GrahamWidmann/420handheldproject/Documentation/01-ConceptDevelopment-GW.pdf

Graham Widmann

Step 01

Tools, brush sizes, and hardness levels are difficult to find and tough to change mid-edit without opening other tabs and loosing concentration on the current editable area.

I plan on making a device that will attach a computer and allow the user to have quick access to certain tools that are hard to get access to without opening new windows. There will be a screen that will make it easy to get to tools like the hardness and size levels. There will also be some other tools like the brush, gradient, and pen tool. There will be a trackball as well to make it easy to zoom out readjust your seeing area.

Influences:

- Trackball mouse

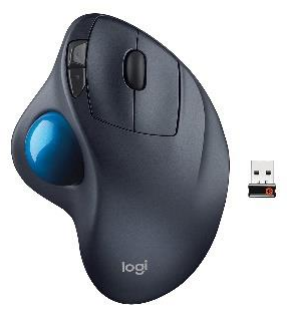
[picture p6: figure]

- I plan on modeling the attachment after a trackball mouse with a small screen near the finger tips.
- https://www.amazon.com/gp/product/B0043T7FXE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 (https://www.amazon.com/gp/product/B0043T7FXE)
- Programmable keyboard

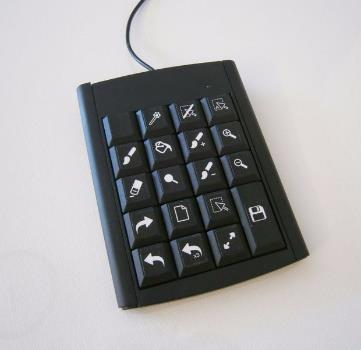
[picture p7: figure]

- Keys like this will be used for activation of different tools within photoshop. Many of them will be digital or be more ergonomically fit.
- http://www.instructables.com/id/Making-a-powerful-programmable-keypad-for-lesstha/ (http://www.instructables.com/id/Making-a-powerful-programmable-keypad-for-less-tha/)

- Corsair Scimitar PRO RGB Optical Moba/MMO Gaming Mouse

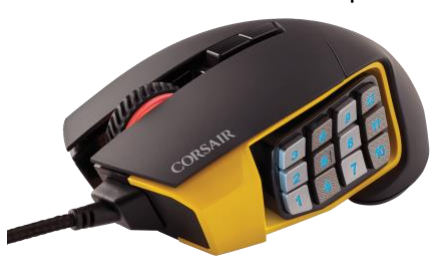
[picture p8: figure]

- I plan on using a layout like the one on this mouse so that all the buttons are easily accessible and reachable for the user. It should be as easy as possible to use.
- https://www.newegg.com/Product/Product.aspx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
N82E16826816069&gclid=EAIaIQobChMIhbaByIDb2AIVDtlkCh0MZAyXEAkYASABEgITTfD _BwE&gclsrc=aw.ds (https://www.newegg.com/Product/Product.aspx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)
