GrahamWidmann/420handheldproject/Documentation/08_Form Production.pdf

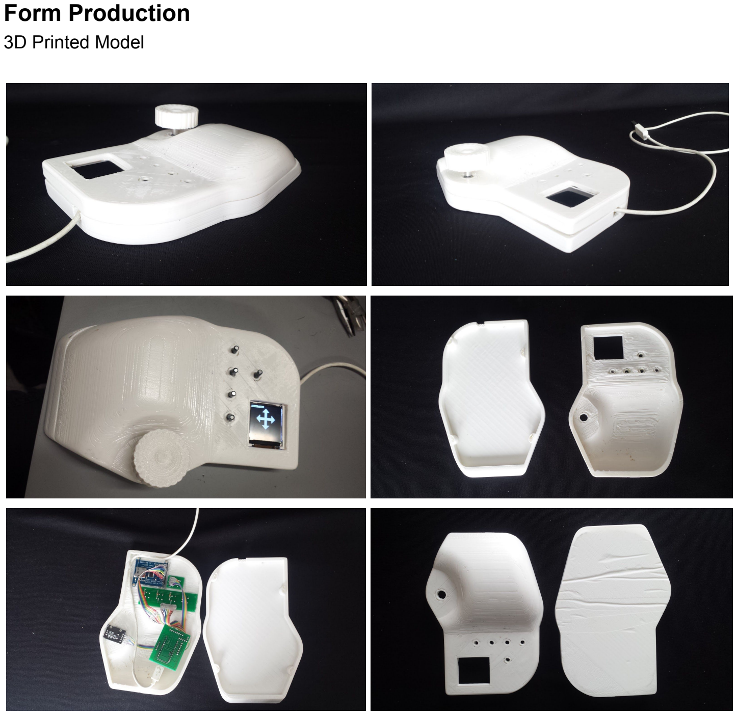
[picture p11: page 1]

### Form Production

3D Printed Model
