GrahamWidmann/420handheldproject/Documentation/07_Function Production.pdf

### Function Production

Finalized Software
The Code is in my GitHub in the code folder. It has the following libraries: Adafruit GFX Library
Adafruit

Printed PCB

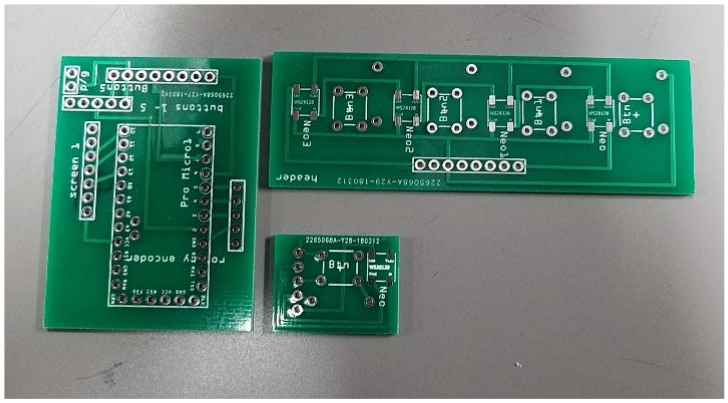
[picture p12: figure]

Combined Components

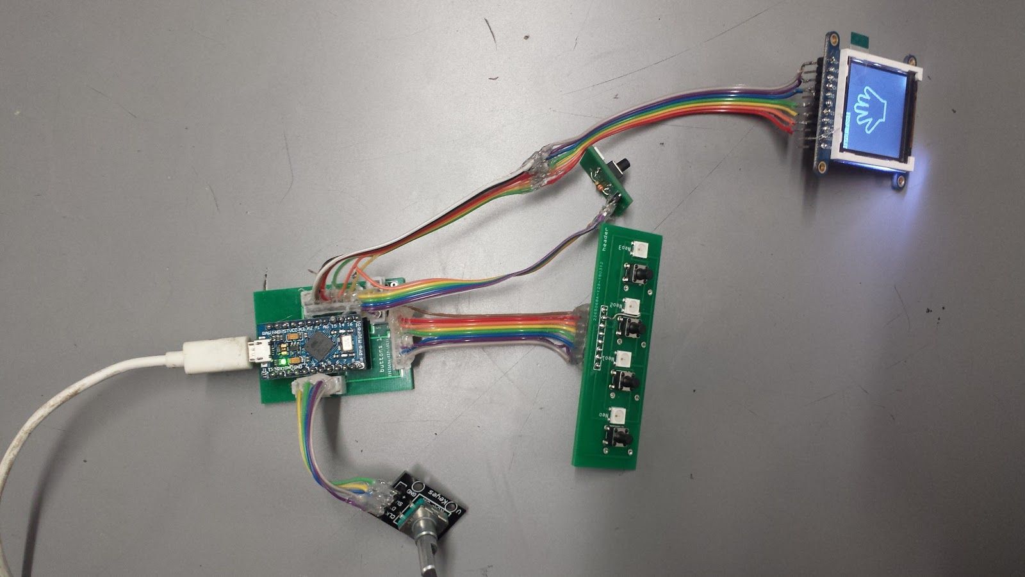
[picture p13: figure]
