GrahamWidmann/420handheldproject/Documentation/04-Function Development_GW.pdf

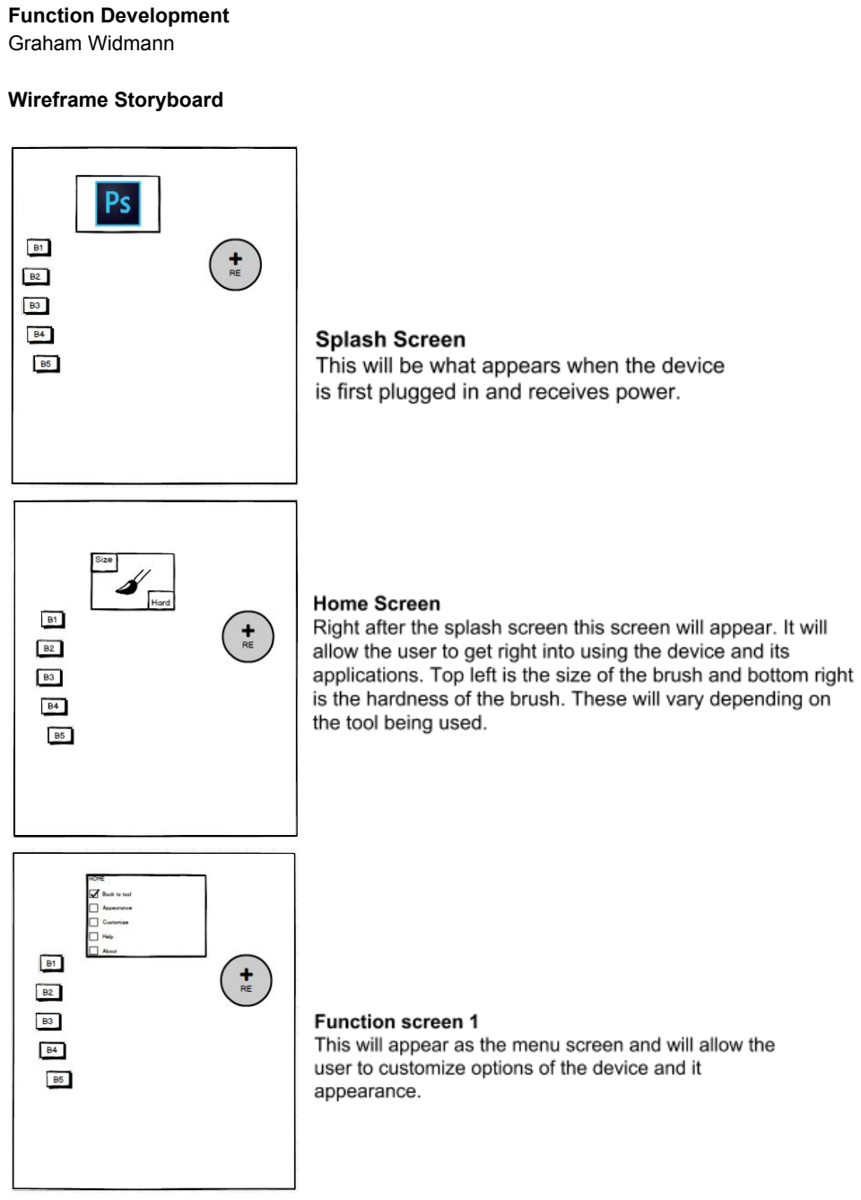
[picture p17: page 1]

Function Development
Graham Widmann

Wireframe Storyboard

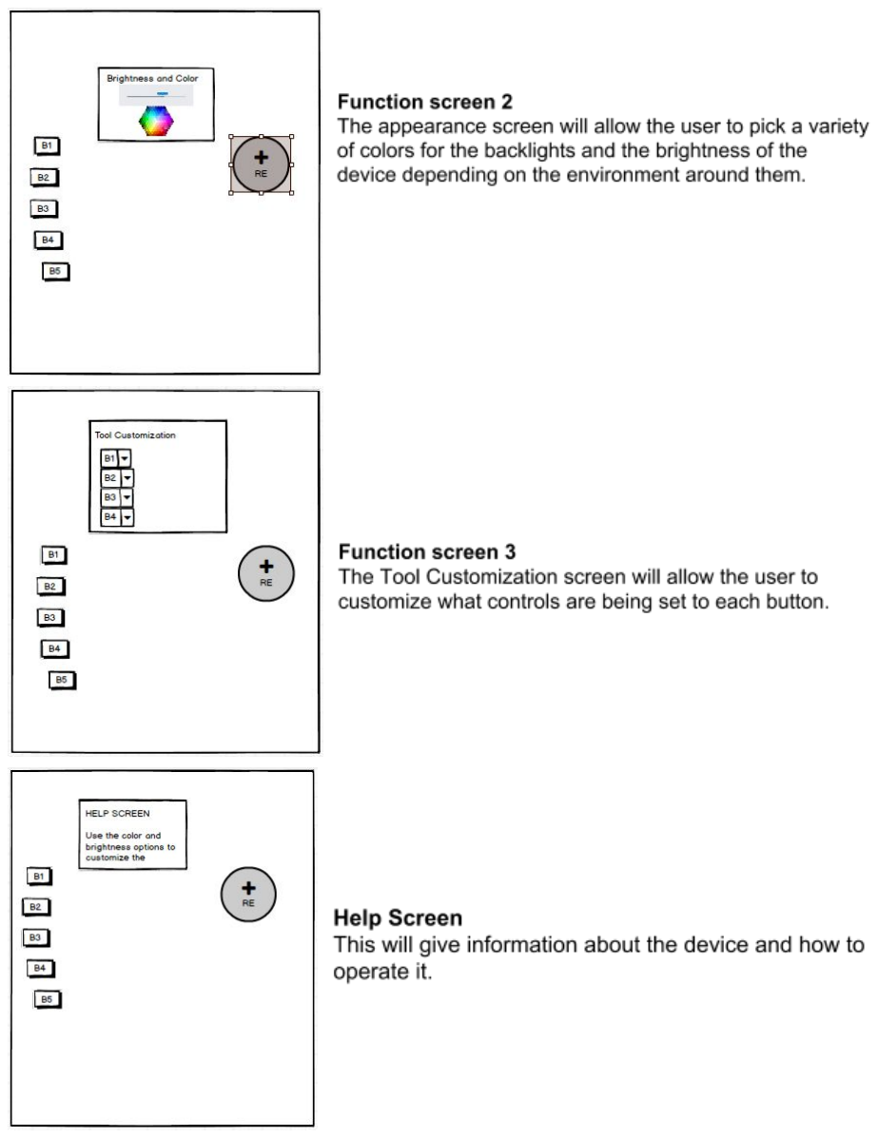
[picture p18: page 2]

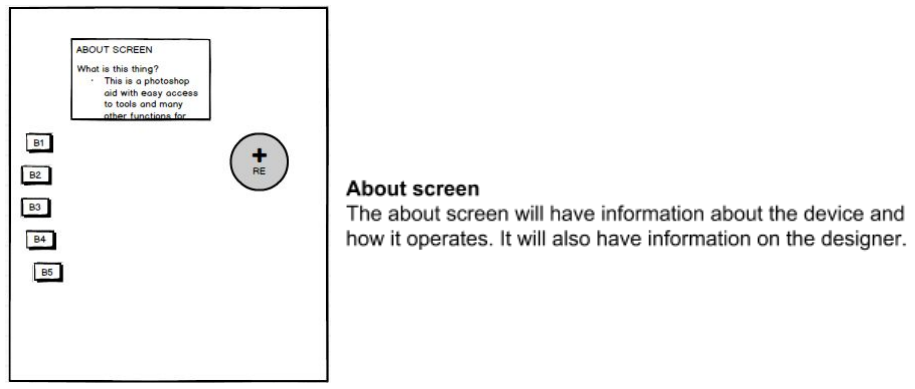
[picture p19: figure]

Component Sketch

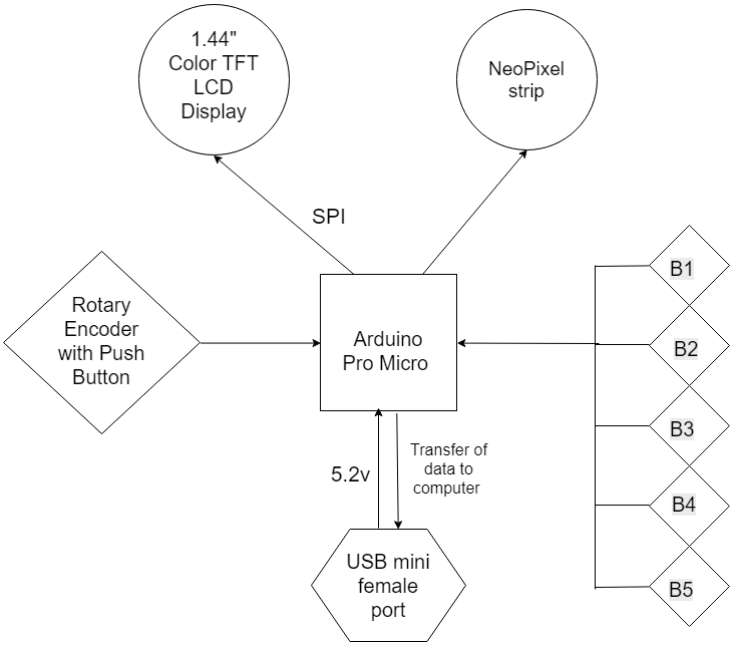
[picture p20: figure]

Bill of materials

Name | Source | URL | Qty. bought | Qty. Used | Cost ($)
Arduino Pro Micro | Amazon | https://goo.gl/iLcZLu | 1 | 1 | 7.98
Push Buttons | Amazon | https://goo.gl/GPt8HP | 140 | 5 | 9.99
Rotary Encoder | Amazon | https://goo.gl/AovCwu | 1 | 1 | 6.45
10k Resistors | Amazon | https://goo.gl/ZGPK4U | 100 | 7 | 6.43
1.44" Color TFT LCD Display with MicroSD Card breakout - ST7735R | Amazon | https://goo.gl/hdFoF1 | 1 | 1 | 18.29
Male Header pins | Amazon | https://goo.gl/6y4iy7 | 800 | 40 | 6.99
Female/ female jumper wires | Amazon | https://goo.gl/t5MnrA | 120 | 40 | 6.98

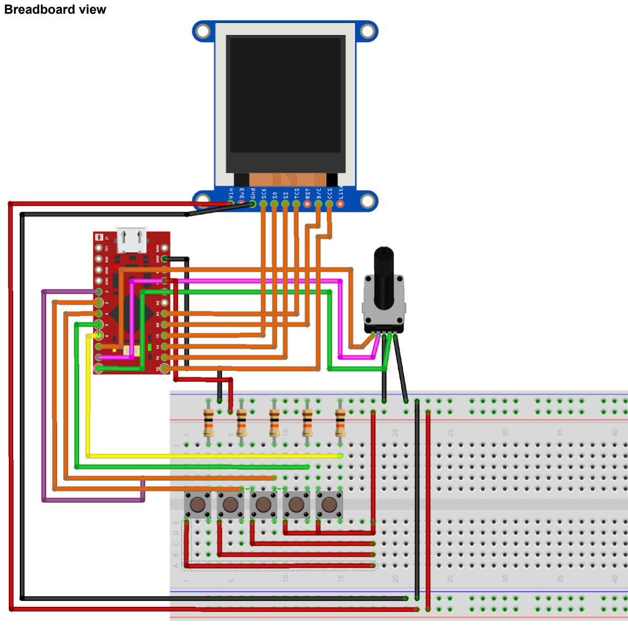
[picture p21: page 6]

Breadboard view

Electronic schematic view

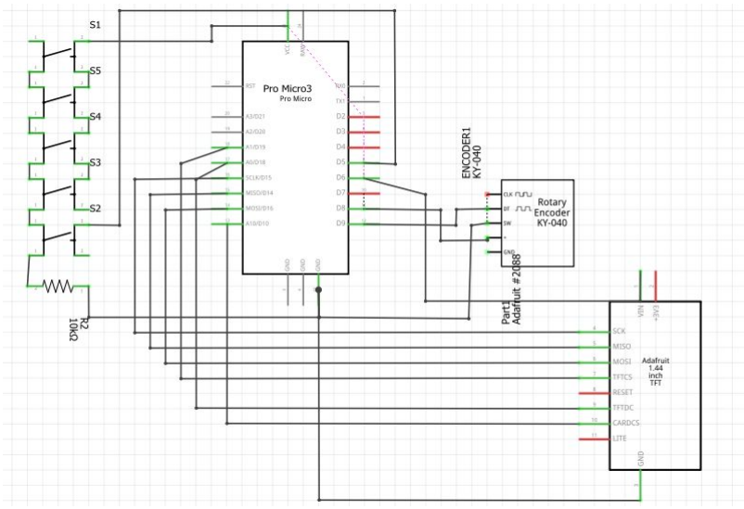
[picture p22: figure]
