GrahamWidmann/420handheldproject/Documentation/09_Finalization.pdf

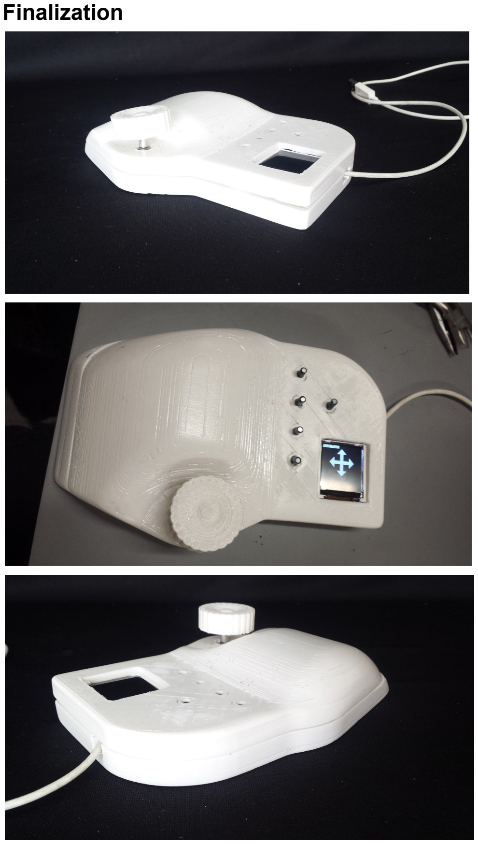
[picture p23: page 1]

Finalization
