GrahamWidmann/420handheldproject/Documentation/06_Form Proof.pdf

05_Form Proof
Graham Widmann

Renderings of mouse

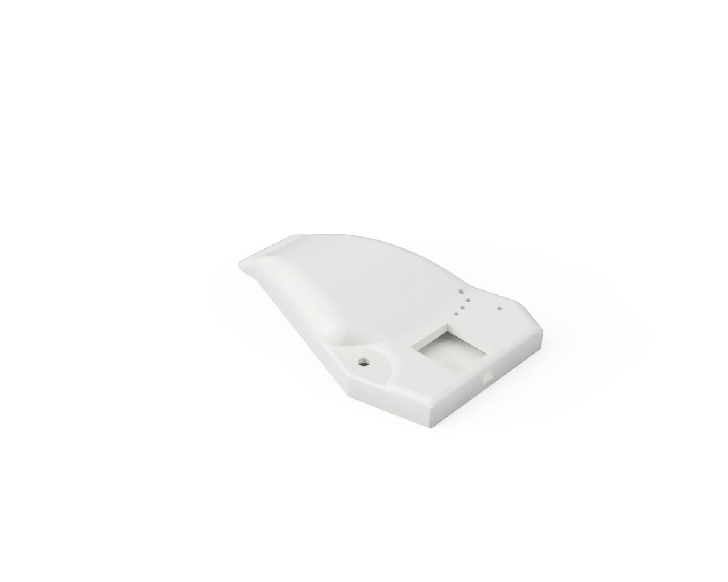
[picture p24: figure]
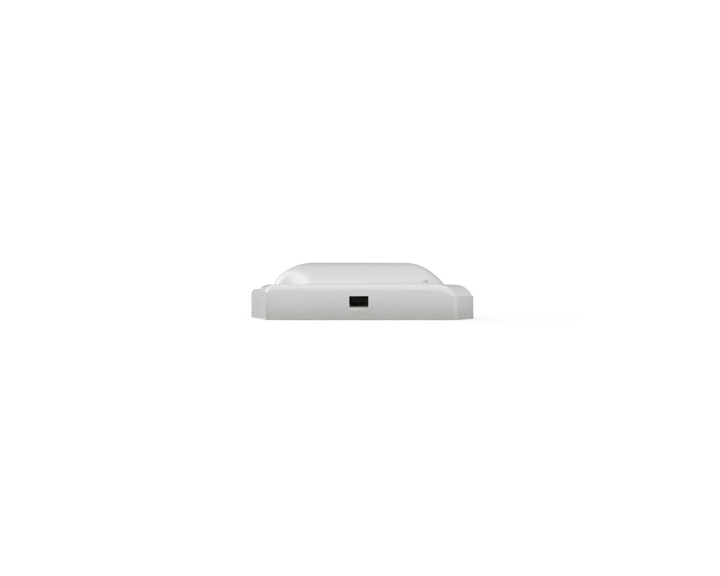
[picture p25: figure]
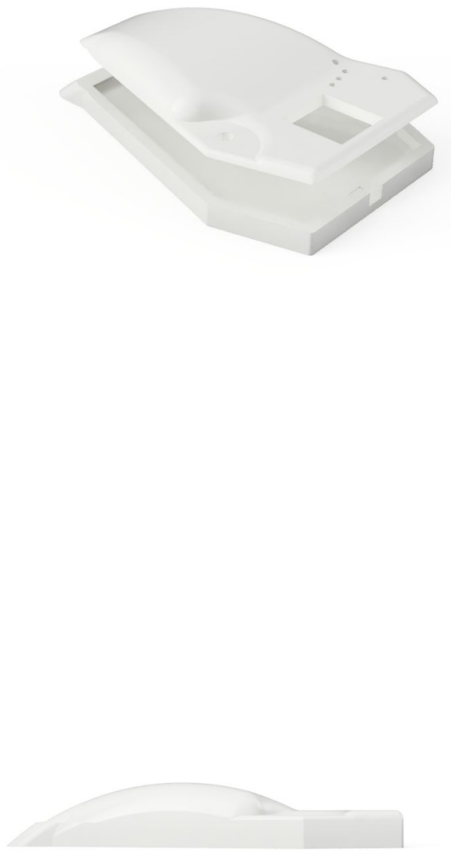
[picture p26: page 2]

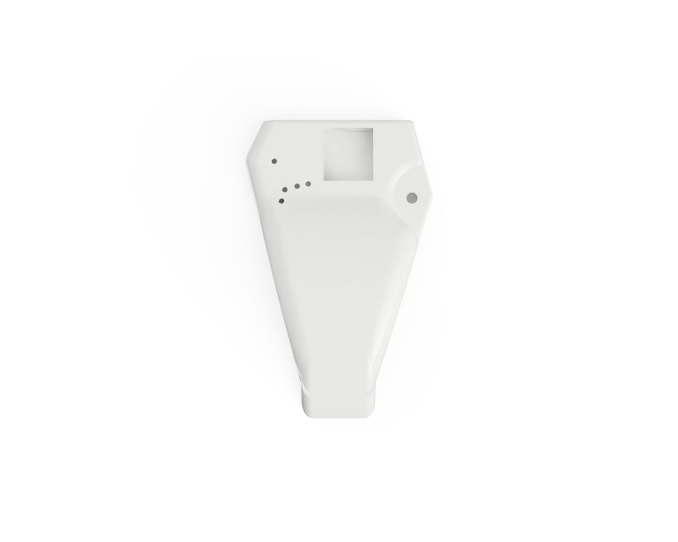
[picture p27: figure]
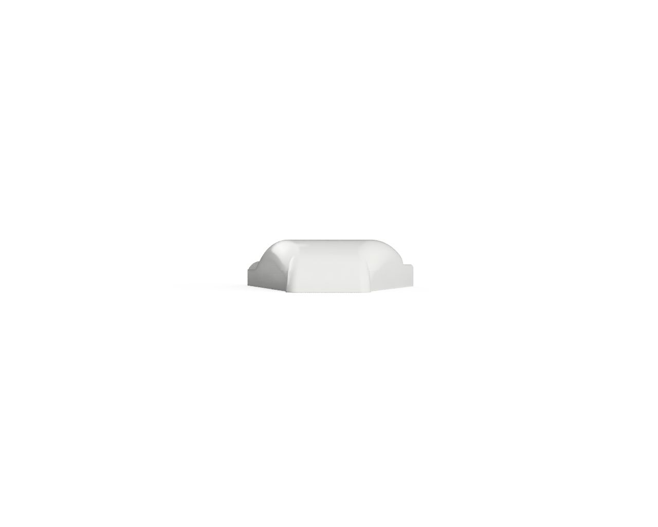
[picture p28: figure]
