GrahamWidmann/420handheldproject/(threads)

Thread 2 (2018-02-07):

03 Feedback

zanecochran, 2018-02-07:
Outputs - I would use individual NeoPixels (WS2812B SMD) instead of a strand. That way you will be able to solder these to a board instead of having them loose in your device.
Power - You should include a USB female connector to your device so it can be plugged in.
