GrahamWidmann/420handheldproject/(list of files, drawings)

Other design files:
PCB/pcb for micro v2 with new plug in buttons.fzz
PCB/pcb for push buttons 2.fzz
PCB/pcb for push buttons.fzz
PCB/pcb for rotary encoder.fzz
