GrahamWidmann/420handheldproject/Code/Graham_Widmann_program_for_420.1/Graham_Widmann_program_for_420.1.ino

const unsigned char brushToolBitmap [] PROGMEM = {
  // 'brush2, 128x100px
  0x00, 0x00, 0x00, 0x00, 0x00, 0x00, 0x00, 0x00, 0x00, 0x00, 0x00, 0x00, 0x00, 0x00, 0x00, 0x00,
  0x00, 0x00, 0x00, 0x00, 0x00, 0x00, 0x00, 0x00, 0x00, 0x00, 0x00, 0x00, 0x00, 0x00, 0x00, 0x00,
  0x00, 0x00, 0x00, 0x00, 0x00, 0x00, 0x00, 0x00, 0x00, 0x00, 0x00, 0x00, 0x00, 0x00, 0x00, 0x00,
  0x00, 0x00, 0x00, 0x00, 0x00, 0x00, 0x00, 0x00, 0x00, 0x00, 0x00, 0x00, 0x00, 0x00, 0x00, 0x00,
  0x00, 0x00, 0x00, 0x00, 0x00, 0x00, 0x00, 0x00, 0x00, 0x00, 0x00, 0x00, 0x00, 0x00, 0x00, 0x00,
  0x00, 0x00, 0x00, 0x00, 0x00, 0x00, 0x00, 0x00, 0x00, 0x00, 0x00, 0x00, 0x00, 0x00, 0x00, 0x00,
  0x00, 0x00, 0x00, 0x00, 0x00, 0x00, 0x00, 0x00, 0x00, 0x00, 0x00, 0x00, 0x00, 0x00, 0x00, 0x00,
  0x00, 0x00, 0x00, 0x00, 0x00, 0x00, 0x00, 0x00, 0x00, 0x00, 0x00, 0x00, 0x00, 0x00, 0x00, 0x00,
  0x00, 0x00, 0x00, 0x00, 0x00, 0x00, 0x00, 0x00, 0x00, 0x00, 0x00, 0x00, 0x00, 0x00, 0x00, 0x00,
  0x00, 0x00, 0x00, 0x00, 0x00, 0x00, 0x00, 0x00, 0x00, 0x00, 0x00, 0x00, 0x00, 0x00, 0x00, 0x00,
  0x00, 0x00, 0x00, 0x00, 0x00, 0x00, 0x00, 0x00, 0x00, 0x00, 0x00, 0x00, 0x00, 0x00, 0x00, 0x00,
  0x00, 0x00, 0x00, 0x00, 0x00, 0x00, 0x00, 0x00, 0x00, 0x00, 0x00, 0x00, 0x00, 0x00, 0x00, 0x00,
  0x00, 0x00, 0x00, 0x00, 0x00, 0x00, 0x00, 0x00, 0x00, 0x00, 0x00, 0x00, 0x00, 0x00, 0x00, 0x00,
  0x00, 0x00, 0x00, 0x00, 0x00, 0x00, 0x00, 0x00, 0x00, 0x00, 0x00, 0x00, 0x00, 0x00, 0x00, 0x00,
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
  0x00, 0x00, 0x07, 0x80, 0x00, 0x00, 0x00, 0x07, 0x00, 0x00, 0x00, 0x00, 0x00, 0x00, 0x00, 0x00,
  0x00, 0x00, 0x0f, 0x00, 0x00, 0x00, 0x00, 0x03, 0x80, 0x00, 0x00, 0x00, 0x00, 0x00, 0x00, 0x00,
  0x00, 0x00, 0x0e, 0x01, 0xe0, 0x00, 0x00, 0x03, 0xc0, 0x00, 0x00, 0x00, 0x00, 0x00, 0x00, 0x00,
  0x00, 0x00, 0x1c, 0x07, 0xf0, 0x00, 0x00, 0x01, 0xc0, 0x00, 0x00, 0x00, 0x00, 0x00, 0x00, 0x00,
  0x00, 0x00, 0x1c, 0x0f, 0xf0, 0x00, 0x00, 0x01, 0xe0, 0x00, 0x00, 0x00, 0x00, 0x00, 0x00, 0x00,
  0x00, 0x00, 0x38, 0x0f, 0xf0, 0x00, 0x00, 0x00, 0xe0, 0x00, 0x00, 0x00, 0x00, 0x00, 0x00, 0x00,
  0x00, 0x00, 0x38, 0x1f, 0xf0, 0x00, 0x00, 0x00, 0xf0, 0x00, 0x00, 0x00, 0x00, 0x00, 0x00, 0x00,
  0x00, 0x00, 0x78, 0x3f, 0xf0, 0x00, 0x00, 0x00, 0x70, 0x00, 0x00, 0x00, 0x00, 0x00, 0x00, 0x00,
  0x00, 0x00, 0x70, 0x3f, 0xf0, 0x00, 0x00, 0x00, 0x70, 0x00, 0x00, 0x00, 0x00, 0x00, 0x00, 0x00,
  0x00, 0x00, 0x70, 0x7f, 0xe0, 0x00, 0x00, 0x00, 0x70, 0x00, 0x00, 0x00, 0x00, 0x00, 0x00, 0x00,
  0x00, 0x00, 0x70, 0x7f, 0xe0, 0x00, 0x00, 0x00, 0x38, 0x00, 0x00, 0x00, 0x00, 0x00, 0x00, 0x00,
  0x00, 0x00, 0x60, 0x7f, 0xc0, 0x00, 0x00, 0x00, 0x38, 0x00, 0x00, 0x00, 0x00, 0x00, 0x00, 0x00,
  0x00, 0x00, 0xe0, 0x7f, 0x80, 0x00, 0x00, 0x00, 0x38, 0x00, 0x00, 0x00, 0x00, 0x00, 0x00, 0x00,
  0x00, 0x00, 0xe0, 0x7f, 0x80, 0x00, 0x00, 0x00, 0x38, 0x00, 0x00, 0x00, 0x00, 0x00, 0x00, 0x00,
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
};

#include <Adafruit_NeoPixel.h>
#include <RotaryEncoder.h>

#include <Adafruit_GFX.h>    // Core graphics library
#include <Adafruit_ST7735.h> // Hardware-specific library
#include <SPI.h>

#define TFT_CS     10
#define TFT_RST    8  // you can also connect this to the Arduino reset
// in which case, set this #define pin to -1!
#define TFT_DC     9

Adafruit_ST7735 tft = Adafruit_ST7735(TFT_CS,  TFT_DC, TFT_RST);

#define TFT_SCLK 15   // set these to be whatever pins you like!
#define TFT_MOSI 16   // set these to be whatever pins you like!

#include <Keyboard.h>

#define black 0x0000
#define white 0xFFFFFF
#define red 0xFF0000
#define green 0x00FF00
#define blue 0x0000FF
#define pink 0xFFC0CB

#define PIN 6

Adafruit_NeoPixel strip = Adafruit_NeoPixel(15, PIN, NEO_GRB + NEO_KHZ800);

#define KEY_LEFT_SHIFT  0x81

//ACTUAL CODE BELOW


int bS = digitalRead(3);
boolean letitgo = false;
boolean bitmapDrawn = false;

RotaryEncoder myEnc (5, 4);

int rot = 0;
int mode = 0;// for the potentiometer
int lastMode = -1;
int lastMenu = -1;
int numMode = 9;
long oldPosition  = -999;
int dir = 0;
int lastColor = -1;
int i = 0;

void setup(void) {

  tft.initR(INITR_144GREENTAB);

  pinMode(2, INPUT_PULLUP);//automatically turns to high //move
  pinMode(3, INPUT_PULLUP);//automatically turns to high //hand
  pinMode(7, INPUT_PULLUP);//automatically turns to high //pen
  pinMode(A0, INPUT_PULLUP);//automatically turns to high //zoom
  pinMode(A1, INPUT_PULLUP);//automatically turns to high //brush
  Keyboard.begin();

  tft.fillScreen(black);

  tft.setTextColor (red, white);

  strip.begin();
  strip.show();

  Serial.begin(9600);

  tft.setRotation(1);
}

void loop() {
  
  tft.setTextSize(1);

  if (lastMode != mode) {
    tft.fillScreen(black);
    lastMode = mode;
    lastMenu = -1;
    bitmapDrawn = false;
  }

  switch (mode) {
    case 0: Splash(); break;
    case 1: buttonPress(); Hand(); break;
    case 2: buttonPress(); Brush(); break;
    case 3: menu(); break;
    case 4: buttonPress(); Pen(); break;
    case 5: buttonPress(); Zoom(); break;
    case 6: buttonPress(); Move(); break;
    case 7: help(); break;
    case 8: about(); break;
    case 9: colors(); break;
  }

  changeBrush();

}
