GrahamWidmann/420handheldproject/Code/Graham_Widmann_program_for_420.1/brush_values.ino

void changeBrush() {
  int enc = checkDial();

  if (enc == 1) {
    bitmapDrawn = false;
    Keyboard.write(93); delay(5);

  }

  if (enc == -1) {
    bitmapDrawn = false;
    Keyboard.write(91); delay(5);

  }
}
