GrahamWidmann/420handheldproject/Code/Graham_Widmann_program_for_420.1/color_wipe.ino

void rEd() {
  for (i = 0; 1 < 5; i++) {
    strip.setPixelColor(5, 255, 0, 0);
    strip.show();
  }]
}

void gReen() {
  for (i = 0; 1 < 5; i++) {
    strip.setPixelColor(i, 0, 255, 0);
    strip.show();
  }
}

void bLue() {
  for (i = 0; 1 < 5; i++) {
    strip.setPixelColor(i, 0, 0, 255);
    strip.show();
  }
}

void pAnk() {
  for (i = 0; 1 < 5; i++) {
    strip.setPixelColor(i, 255, 105, 180);
    strip.show();
  }
}

//]]]]
