GrahamWidmann/420handheldproject/(commit log)

2018-01-22 Added mood board to documentation folder
    Not completed.. still need sketches and other information.
2018-01-22 added mood board
    Not complete. Sketches need as well as other documentation.
2018-01-31 added Function Proposal
    *fingers crossed*
2018-01-31 Uploaded new function proposal
    *fingers double crossed*
2018-03-09 PCBs uploaded
    Micro PCB
    Pushbuttons 1-4
    Pushbutton 5
    Rotary Encoder
    [pcb for micro v2 with new plug in buttons.fzz, pcb for push buttons 2.fzz, pcb for push buttons.fzz, pcb for rotary encoder.fzz]
2018-03-09 Uploaded Code
    Code is not done:
    need to talk to computer
    need to be able to switch screens
    need to be able to use potentiometer to scroll
    need comments
